ZahinTasnim/Morphing-Aircraft-Wings-Eppler-420/E420_700_rotating-squares.step

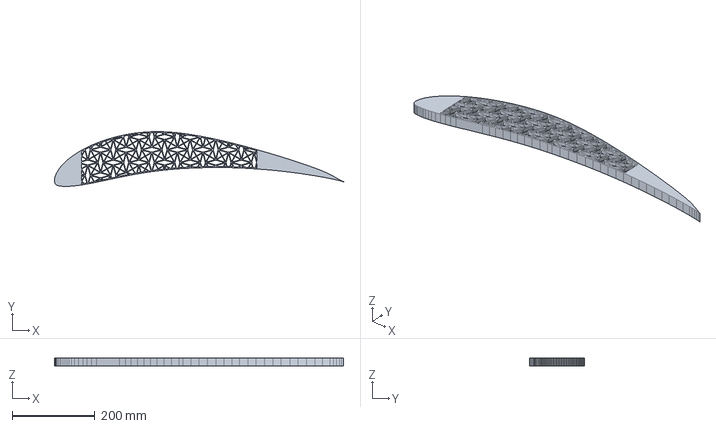
[picture p14: CAD file, 2026-10-11]
E420_700_rotating-squares.step
700.1 x 132.7 x 20.0 mm
