ZahinTasnim/Morphing-Aircraft-Wings-Eppler-420/E420_700_tetrachiral.step

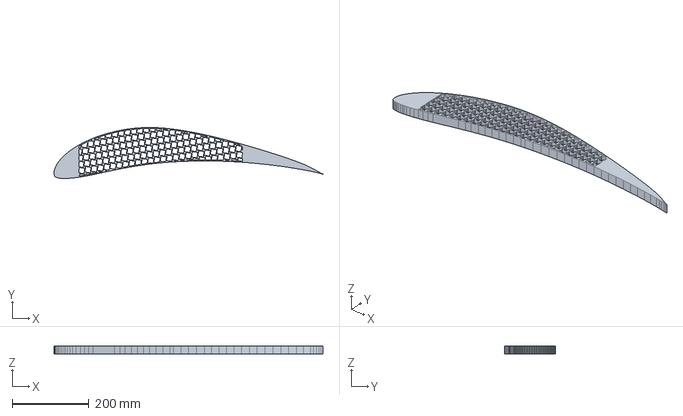
[picture p15: CAD file, 2026-10-11]
E420_700_tetrachiral.step
700.1 x 132.7 x 20.0 mm
