ZahinTasnim/Morphing-Aircraft-Wings-Eppler-420/(list of files, cad)

Other CAD files:
E420_700_double-arrowhead.step
E420_700_hexagonal.step
